AlainPiallat/projet-1A-controleur-moteur/Power-board/Schematics.pdf

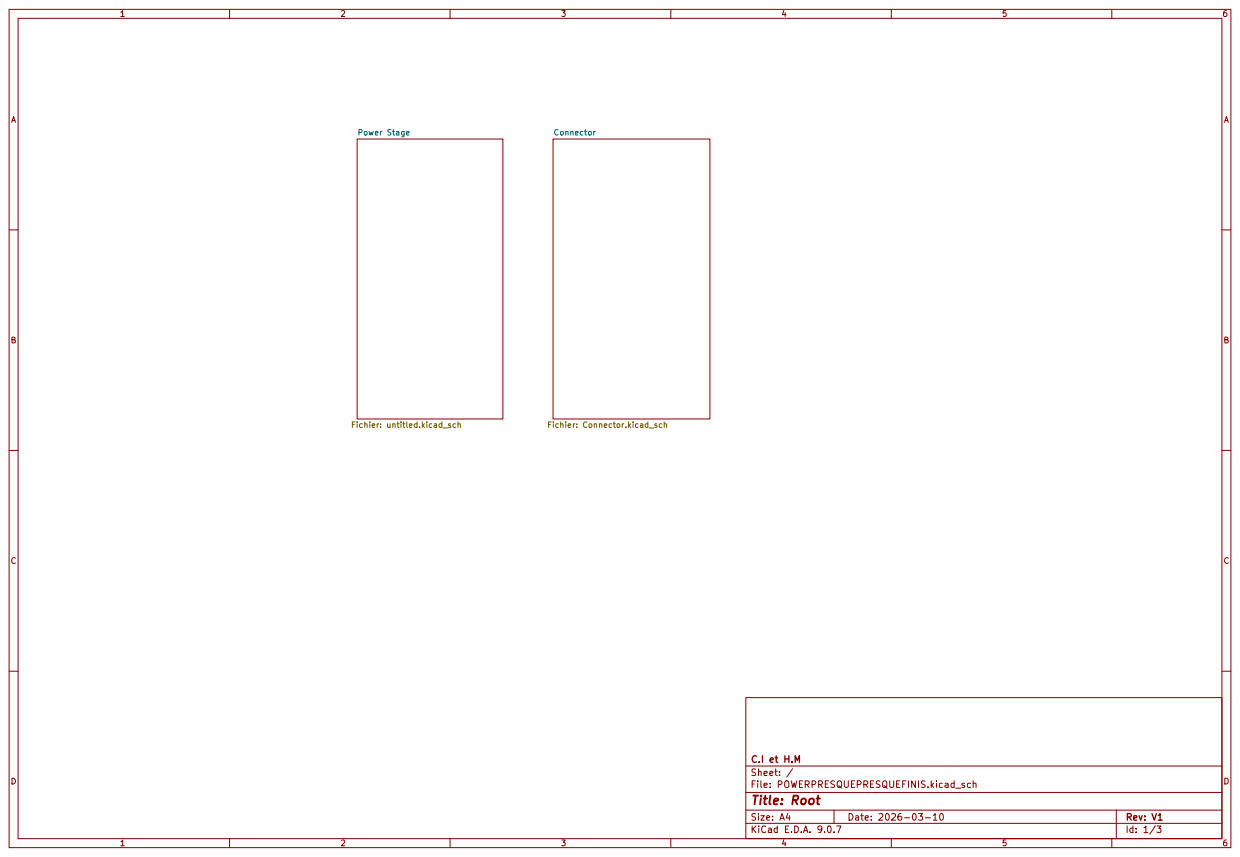
[picture p4: page 1]

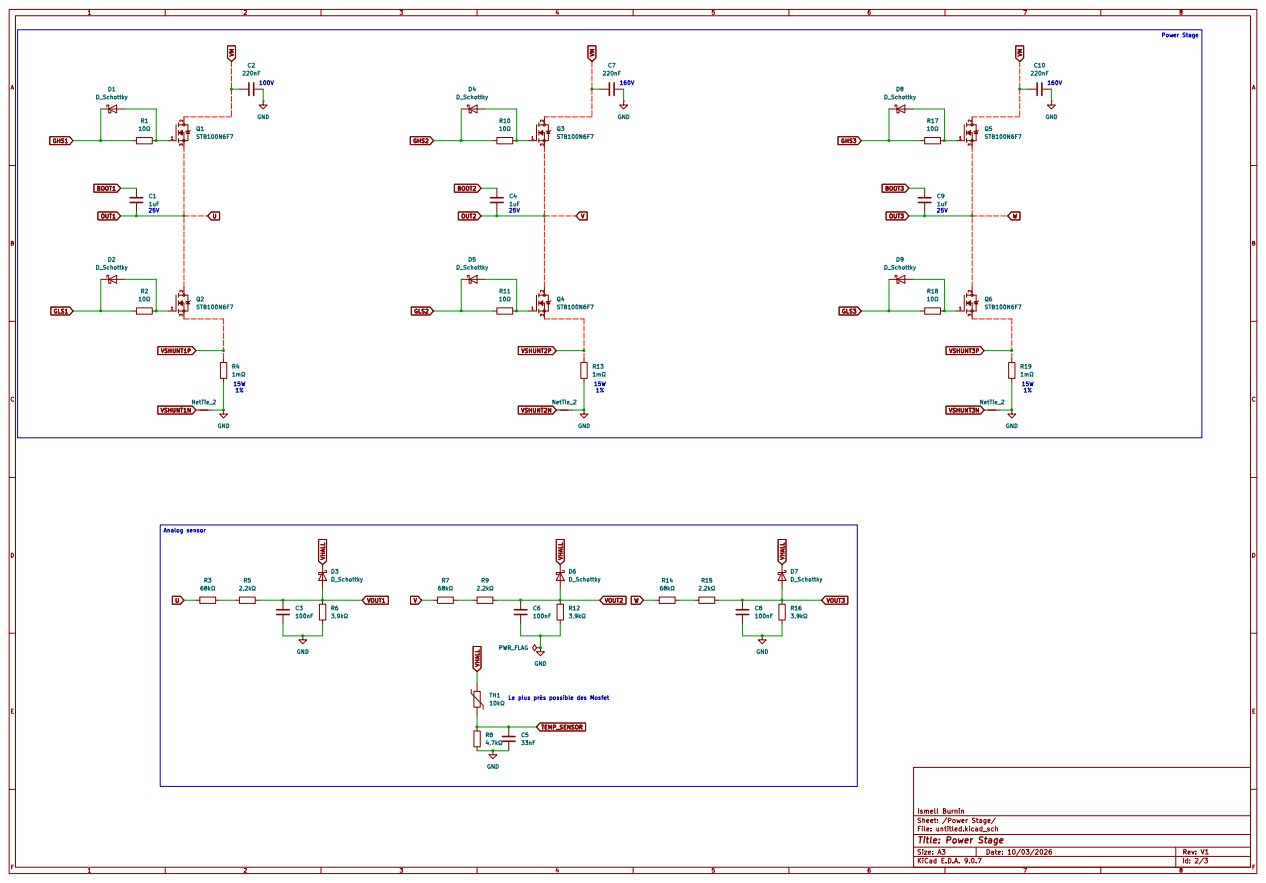
[picture p5: page 2]

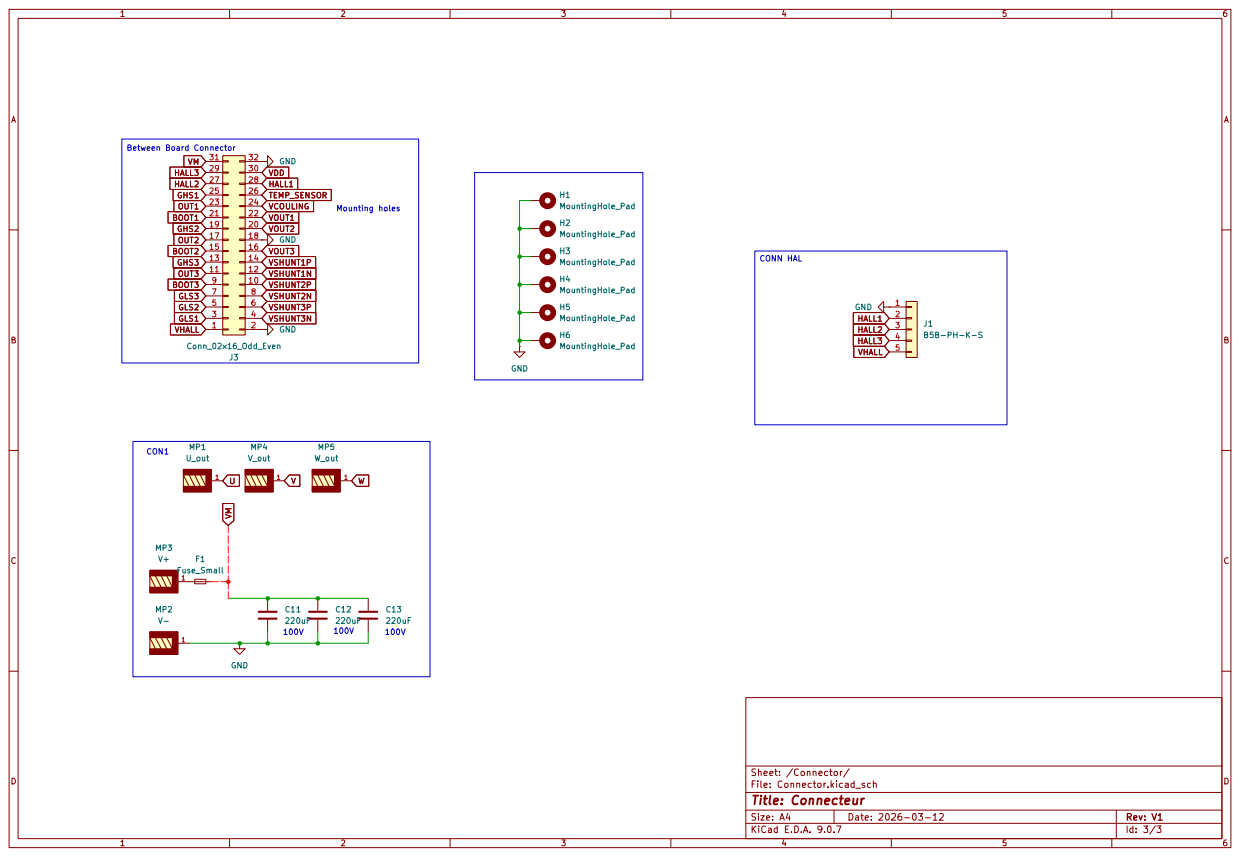
[picture p6: page 3]
