AlainPiallat/projet-1A-controleur-moteur/Power-board/Kicad/PCB_PUISSANCE.kicad_pcb

## KiCad design Power-board/Kicad/PCB_PUISSANCE.kicad_pcb (2026-05-30)

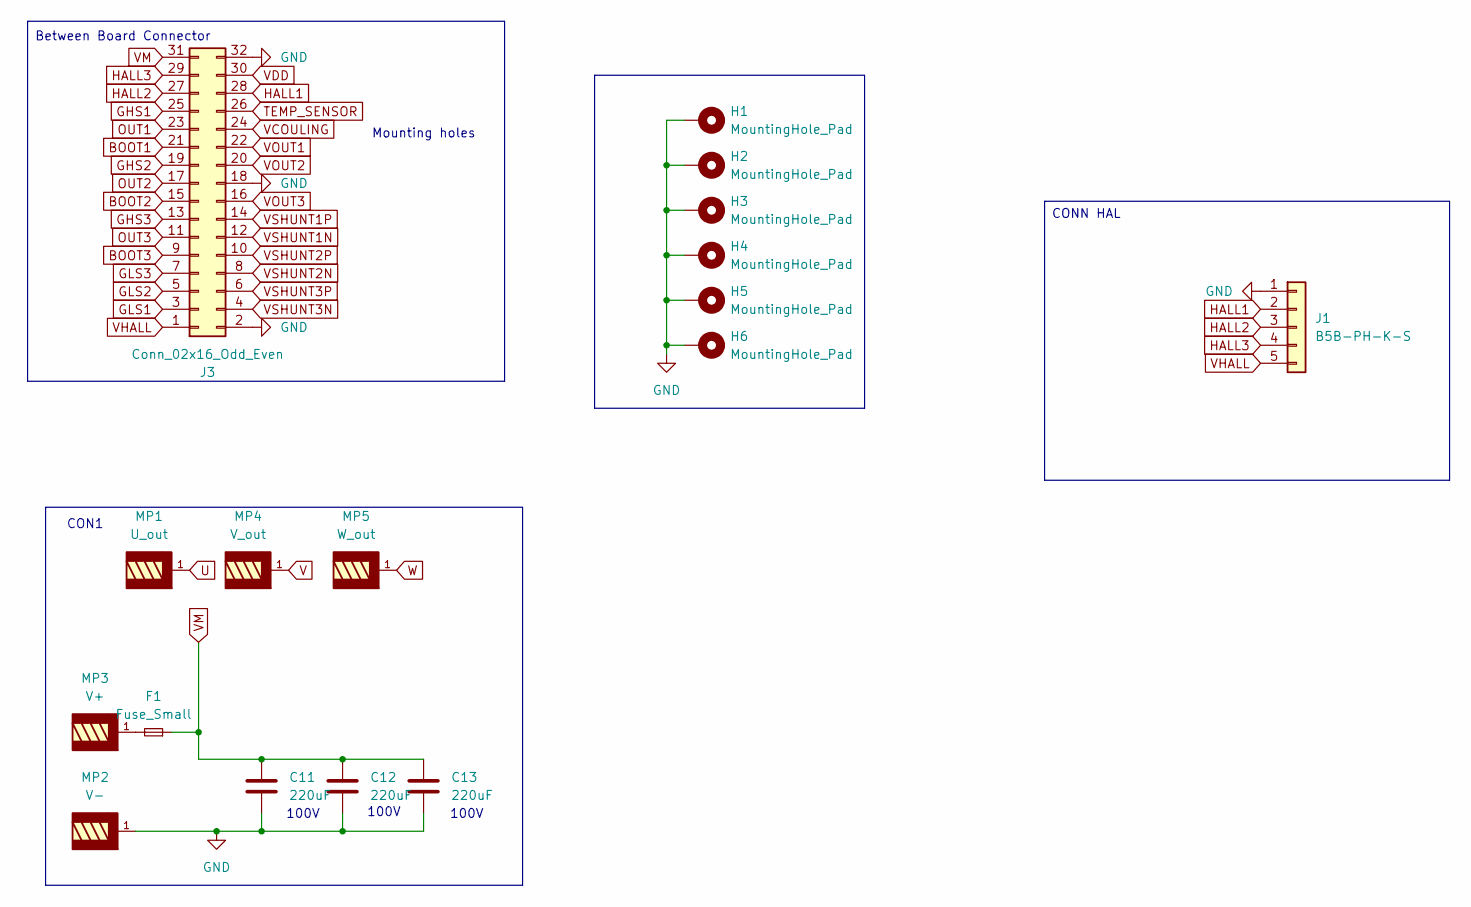
[picture p7: schematic Connector.kicad_sch, Connecteur]

Parts:
C11, C12, C13: 220uF; CP_Radial_D10.0mm_P5.00mm
F1: Fuse_Small; Fuse_3-140-177
H1, H2, H3, H4, H5, H6: MountingHole_Pad; MountingHole_3.2mm_M3_DIN965_Pad
J1: B5B-PH-K-S; JST_B5B-PH-K-S
J3: Conn_02x16_Odd_Even; PinHeader_2x16_P2.54mm_Vertical
MP1: U_out; Wurt
MP2: V-; Wurt
MP3: V+; Wurt
MP4: V_out; Wurt
MP5: W_out; Wurt

Connections:
BOOT1: J3.21; also elsewhere on the board
BOOT2: J3.15; also elsewhere on the board
BOOT3: J3.9; also elsewhere on the board
GHS1: J3.25; also elsewhere on the board
GHS2: J3.19; also elsewhere on the board
GHS3: J3.13; also elsewhere on the board
GLS1: J3.3; also elsewhere on the board
GLS2: J3.5; also elsewhere on the board
GLS3: J3.7; also elsewhere on the board
GND: C11.2, C12.2, C13.2, H1.1, H2.1, H3.1, H4.1, H5.1, H6.1, J1.1, J3.2, J3.18, J3.32, MP2.1, MP2.2, MP2.3, MP2.4; also elsewhere on the board
HALL1: J1.2, J3.28
HALL2: J1.3, J3.27
HALL3: J1.4, J3.29
unnamed: F1.2, MP3.1, MP3.2, MP3.3, MP3.4
OUT1: J3.23, MP1.1, MP1.2, MP1.3, MP1.4; also elsewhere on the board
OUT2: J3.17, MP4.1, MP4.2, MP4.3, MP4.4; also elsewhere on the board
OUT3: J3.11, MP5.1, MP5.2, MP5.3, MP5.4; also elsewhere on the board
TEMP_SENSOR: J3.26; also elsewhere on the board
VCOULING: J3.24
VDD: J3.30
VHALL: J1.5, J3.1; also elsewhere on the board
VM: C11.1, C12.1, C13.1, F1.1, J3.31; also elsewhere on the board
VOUT1: J3.22; also elsewhere on the board
VOUT2: J3.20; also elsewhere on the board
VOUT3: J3.16; also elsewhere on the board
VSHUNT1N: J3.12; also elsewhere on the board
VSHUNT1P: J3.14; also elsewhere on the board
VSHUNT2N: J3.8; also elsewhere on the board
VSHUNT2P: J3.10; also elsewhere on the board
VSHUNT3N: J3.4; also elsewhere on the board
VSHUNT3P: J3.6; also elsewhere on the board

Notes on the sheet:
CON1
100V
Mounting holes
Between Board Connector
CONN HAL

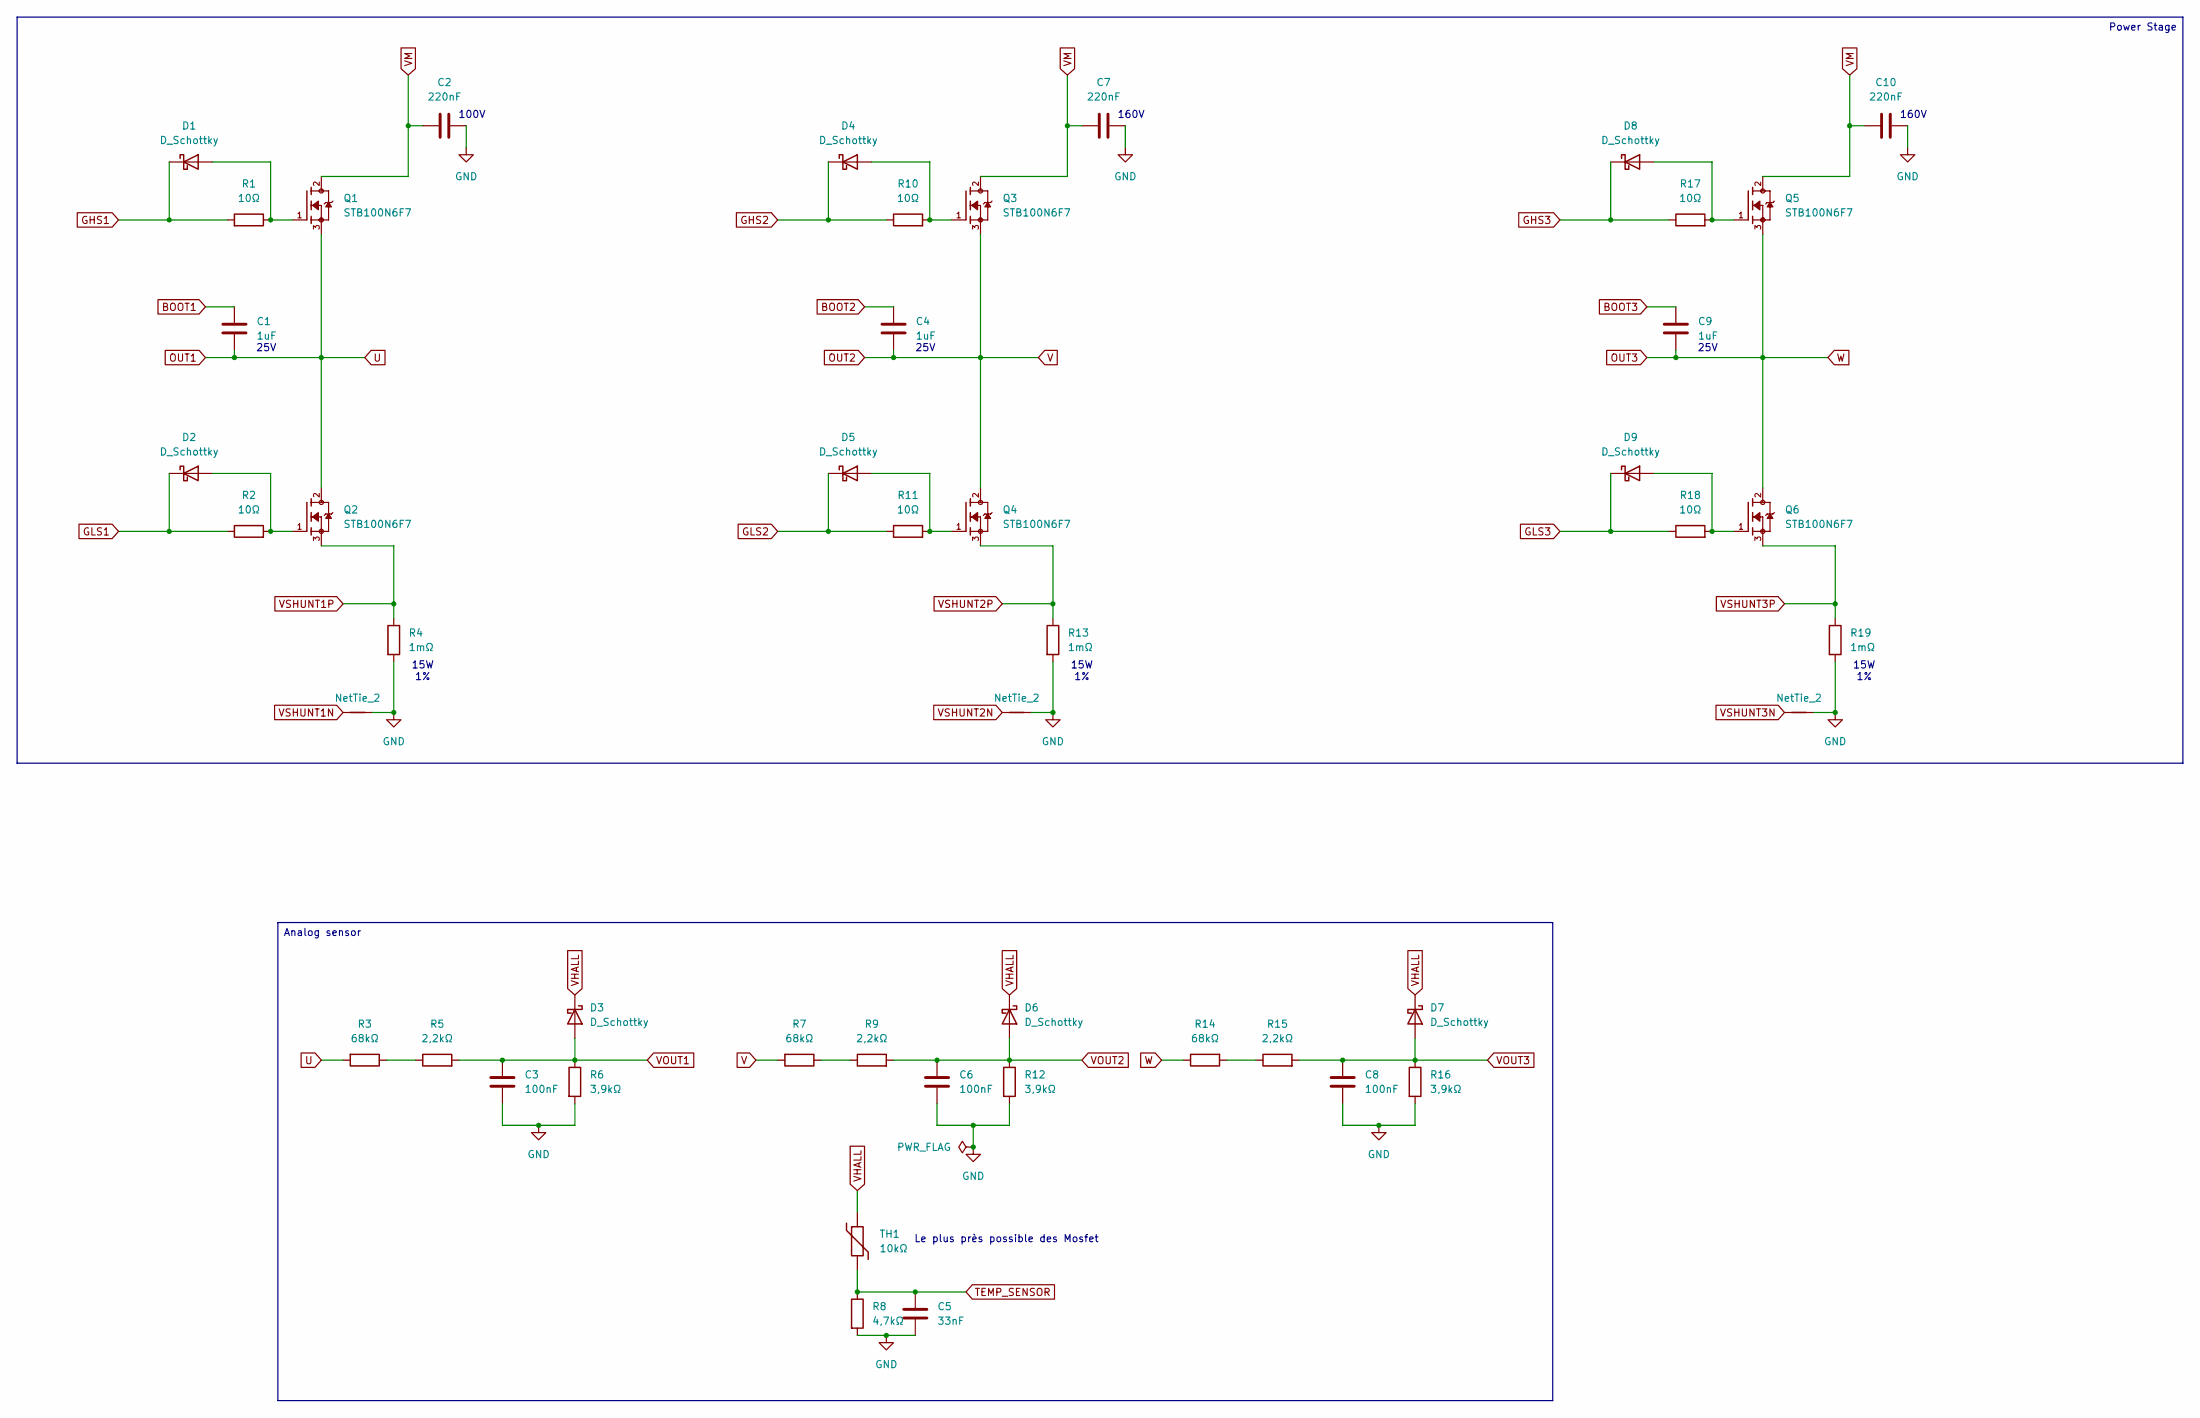
[picture p8: schematic untitled.kicad_sch, Power Stage]

Parts:
C1, C4, C9: 1uF; C_1206_3216Metric_Pad1.33x1.80mm_HandSolder
C2, C7, C10: 220nF; C_1210_3225Metric_Pad1.33x2.70mm_HandSolder
C3, C6, C8: 100nF; C_0805_2012Metric_Pad1.18x1.45mm_HandSolder
C5: 33nF; C_0805_2012Metric_Pad1.18x1.45mm_HandSolder
D1, D2, D3, D4, D5, D6, D7, D8, D9: D_Schottky; D_SOD-123
NT1, NT2, NT3: NetTie_2; NetTie-2_SMD_Pad0.5mm
Q1, Q2, Q3, Q4, Q5, Q6: STB100N6F7
R1, R2, R10, R11, R17, R18: 10Ω; R_1206_3216Metric_Pad1.30x1.75mm_HandSolder
R3, R7, R14: 68kΩ; R_1206_3216Metric_Pad1.30x1.75mm_HandSolder
R4, R13, R19: 1mΩ; PSR500HT
R5, R9, R15: 2,2kΩ; R_1206_3216Metric_Pad1.30x1.75mm_HandSolder
R6, R12, R16: 3,9kΩ; R_0805_2012Metric_Pad1.20x1.40mm_HandSolder
R8: 4,7kΩ; R_0805_2012Metric_Pad1.20x1.40mm_HandSolder
TH1: 10kΩ; THRMC1608X95N

Connections:
BOOT1: C1.1; also elsewhere on the board
BOOT2: C4.1; also elsewhere on the board
BOOT3: C9.1; also elsewhere on the board
GHS1: D1.1 (K), R1.2; also elsewhere on the board
GHS2: D4.1 (K), R10.1; also elsewhere on the board
GHS3: D8.1 (K), R17.1; also elsewhere on the board
GLS1: D2.1 (K), R2.1; also elsewhere on the board
GLS2: D5.1 (K), R11.1; also elsewhere on the board
GLS3: D9.1 (K), R18.1; also elsewhere on the board
GND: C2.2, C3.2, C5.2, C6.2, C7.2, C8.2, C10.2, NT1.2, NT2.2, NT3.2, R4.2, R6.2, R8.2, R12.2, R13.2, R16.2, R19.2; also elsewhere on the board
unnamed: D1.2 (A), Q1.1, R1.1
unnamed: D2.2 (A), Q2.1, R2.2
unnamed: D4.2 (A), Q3.1, R10.2
unnamed: D5.2 (A), Q4.1, R11.2
unnamed: D8.2 (A), Q5.1, R17.2
unnamed: D9.2 (A), Q6.1, R18.2
unnamed: R3.1, R5.1
unnamed: R7.1, R9.1
unnamed: R14.2, R15.1
OUT1: C1.2, Q1.3, Q2.2, R3.2; also elsewhere on the board
OUT2: C4.2, Q3.3, Q4.2, R7.2; also elsewhere on the board
OUT3: C9.2, Q5.3, Q6.2, R14.1; also elsewhere on the board
TEMP_SENSOR: C5.1, R8.1, TH1.2; also elsewhere on the board
VHALL: D3.1 (K), D6.1 (K), D7.1 (K), TH1.1; also elsewhere on the board
VM: C2.1, C7.1, C10.1, Q1.2, Q3.2, Q5.2; also elsewhere on the board
VOUT1: C3.1, D3.2 (A), R5.2, R6.1; also elsewhere on the board
VOUT2: C6.1, D6.2 (A), R9.2, R12.1; also elsewhere on the board
VOUT3: C8.1, D7.2 (A), R15.2, R16.1; also elsewhere on the board
VSHUNT1N: NT1.1; also elsewhere on the board
VSHUNT1P: Q2.3, R4.1; also elsewhere on the board
VSHUNT2N: NT2.1; also elsewhere on the board
VSHUNT2P: Q4.3, R13.1; also elsewhere on the board
VSHUNT3N: NT3.1; also elsewhere on the board
VSHUNT3P: Q6.3, R19.1; also elsewhere on the board

Notes on the sheet:
160V
25V
15W 1%
Le plus près possible des Mosfet
100V
Analog sensor
Power Stage

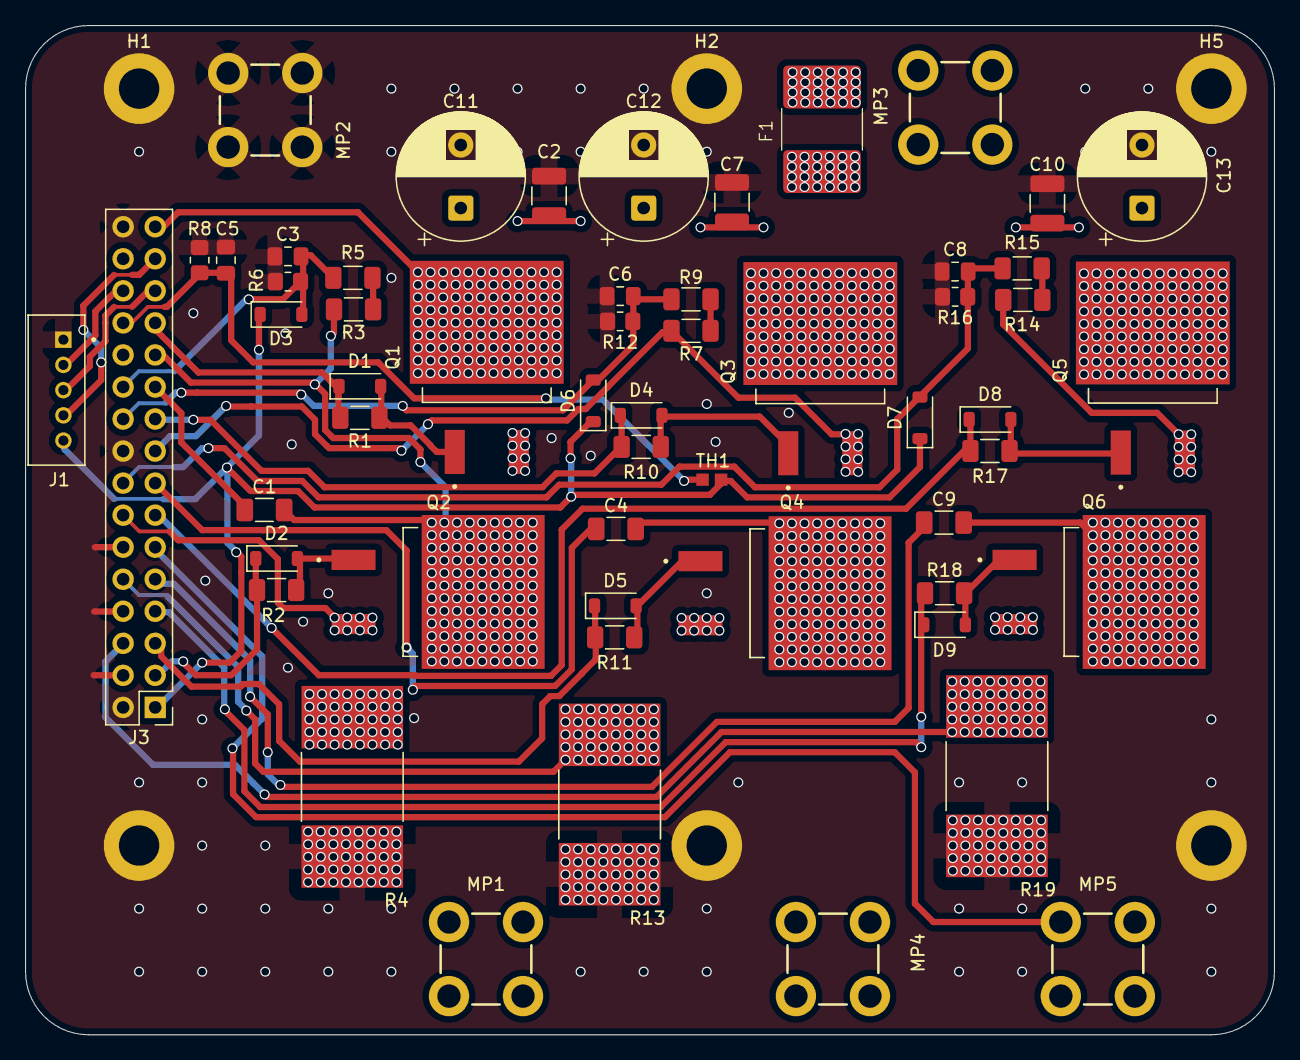
[picture p9: board PCB_PUISSANCE.kicad_pcb from above]

Board: 2 copper layers, 99.0 x 80.0 mm, 65 parts (0 on the bottom side), 38 nets.
