AlainPiallat/projet-1A-controleur-moteur/(commit log)

2026-05-30 Create Power-bord
2026-05-30 Create Schematics
2026-05-30 Rename Power-board/Connecteurs/Rapport_Schematics.md to Power-board/Power/Dimensionnement_des_composants/Readme.md
    Charles tu ranges pas bien ta chambre
2026-05-30 Rename CR_Carte_Puissance_connecteur_hugo.md to Readme.md
    Changement du nom du fichier pour qu'il s'ouvre directement
2026-05-30 Rename Power-board/Connecteurs/Schematics.pdf to Power-board/Schematics.pdf
    Déplacement des schémas au bon endroit
2026-05-30 Delete Power-board/Power/Kicad directory
    Déplacement fichiers kicad
    [Connector.kicad_sch, PCB_PUISSANCE.kicad_pcb, PCB_PUISSANCE.kicad_sch, untitled.kicad_sch]
